ML412/Energy-Monitor-/Project_PCB.png

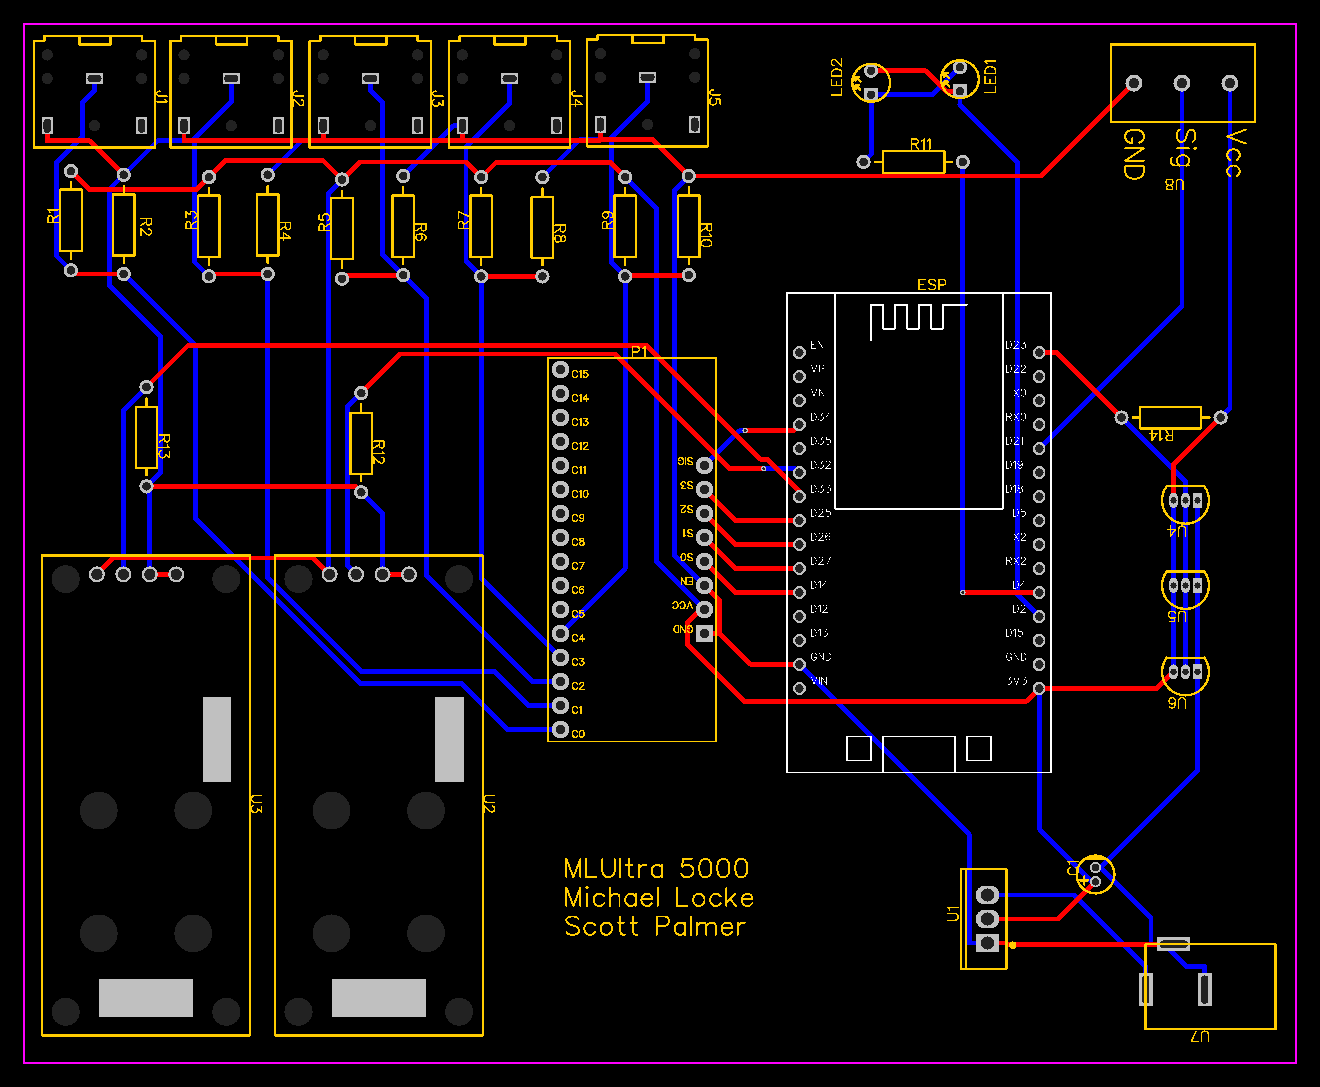
Project_PCB.png
