ML412/Energy-Monitor-/Project_Schematic.png

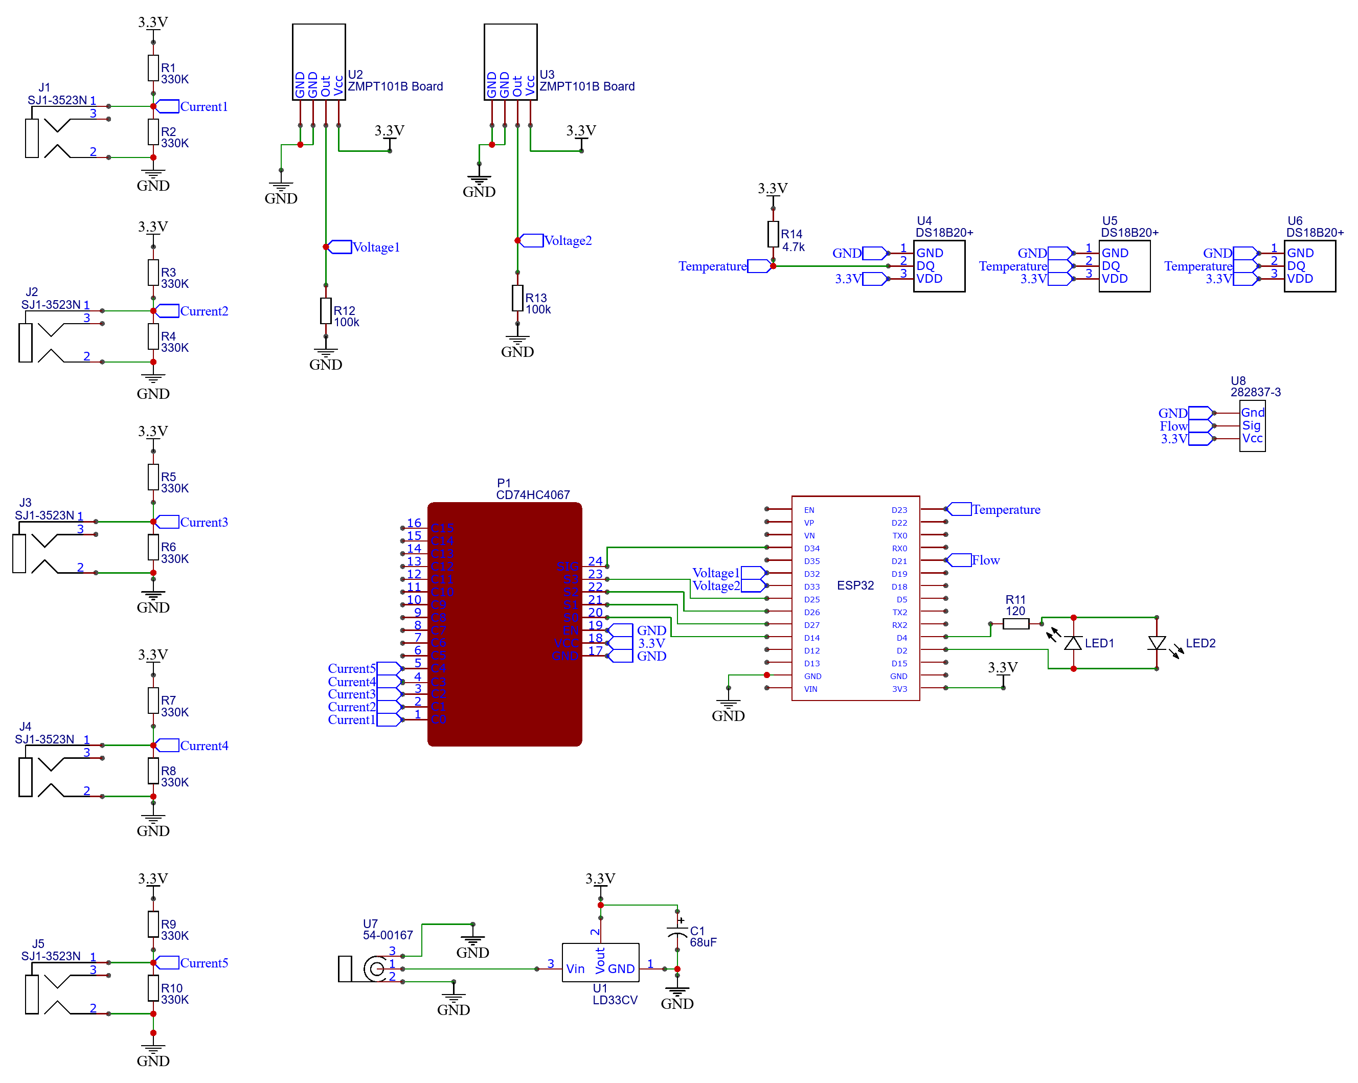
Project_Schematic.png
